barreiroleo/dimmer-rms/readme.md

# Dimmer RMS

**_Se recomienda abrir las imagenes en pestañas nuevas para su mejor visualización._**

## Roadmap

- [x] Acondicionar señal.
- [x] Manejar interrupción.
- [ ] Implementar frecuencimetro.
- [x] Implementar método para obtener tiempo de trigger para objetivo duty.\
       Podría implementarse por busqueda en una tabla o por método numérico.
- [ ] Implementar comunicación I2C con maestro.

## Signal conditioning

Partiendo de una señal alterna dada por una senoidal fundamental y otra senoidal de mayor frecuencia y menor amplitud.

<!-- $$
vsin(t) = 150v \cdot \sin(2\pi \cdot 50Hz  \cdot t)
vnoise(t) = 2v \cdot \sin(2\pi \cdot 10kHz \cdot t)
v(t) = vsin(t) + vnoise(t)
$$ --> 

 
 

Se comparan dos diseños:

- ZCD clásico. Rectificador de onda completa con salida optoacoplada.
- ZCD adaptado. ZCD clásico con amplificador intermedio.

<p align="center">
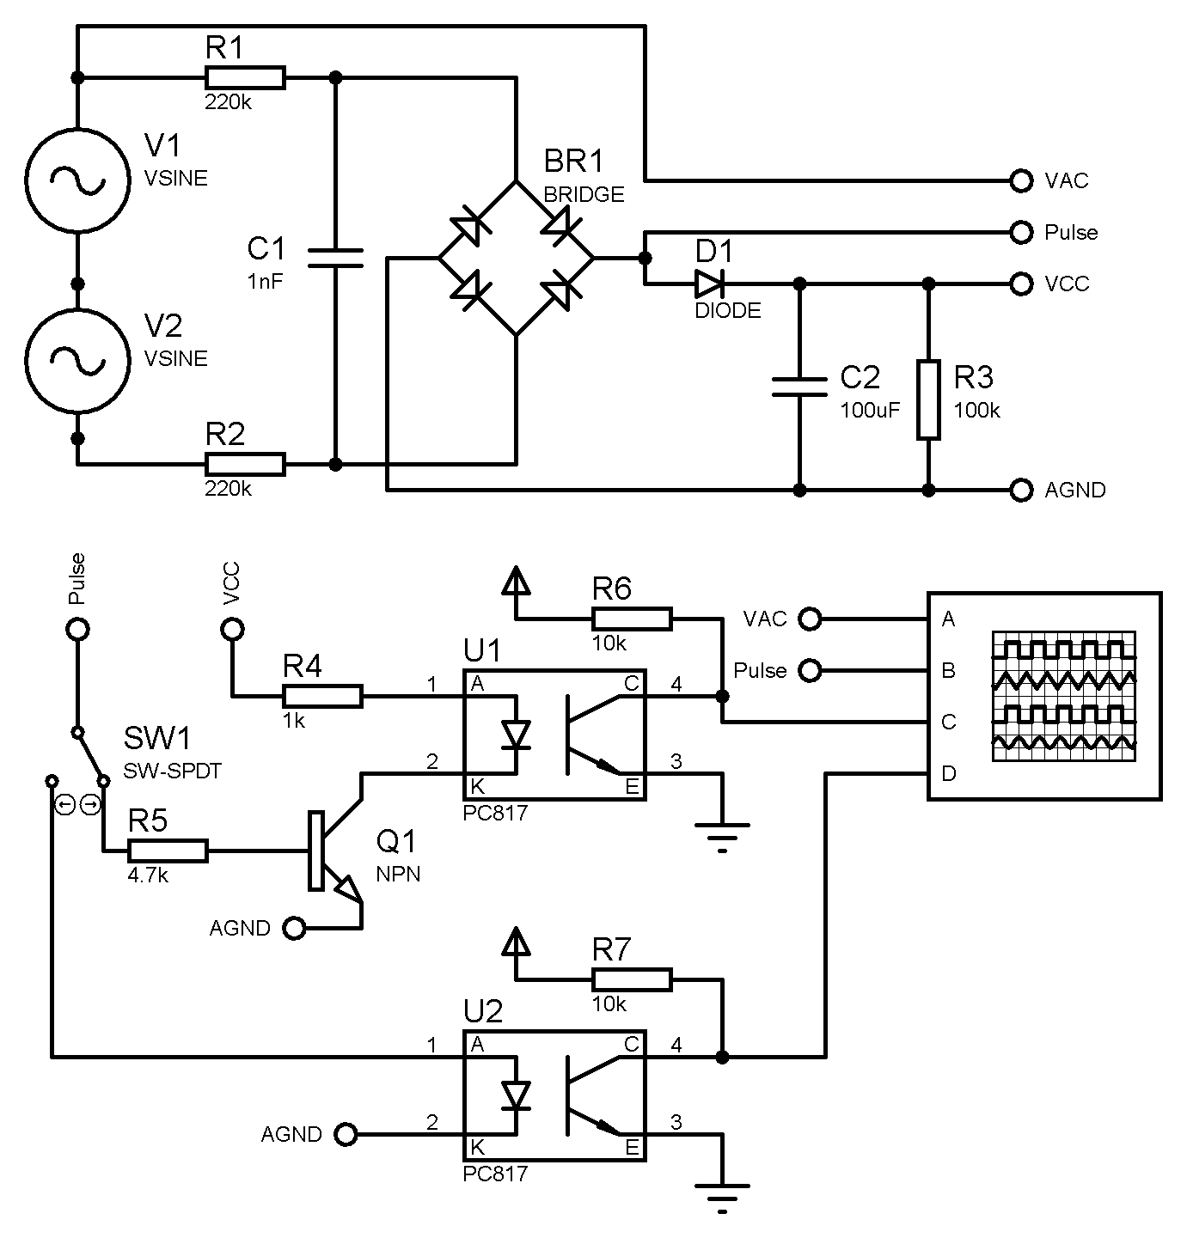
[picture p1: model/ZeroCross/Zero Cross.BMP]

</p>

En el diseño adaptado, se han implementado algunas modificaciones.
- Filtro pasa bajos. Compuesto por R1/C1 y R2/C1 según el semiciclo.
  <!-- $$
  LPF = \frac{1}{(2\pi \cdot 220k\Omega \cdot 1nF)} \approx 720Hz
  $$ --> 
  
- Fuente CC primitiva. Compuesta por D1, C2 y R3. El capacitor de esta fuente debe almacenar la suficiente energía para alimentar al optoacoplador durante la mayor parte del semiperíodo.\
  Las resistencias R1 y R2 deberán tener el valor adecuado para garantizar la recarga de C2 en el tiempo que dure la detección de cruce.
- Amplificador clase E. Permanente en estado alto salvo en los cruces por cruce de cero. En dicho cruce al abrirse Q1, dado el pull up, la salida optoacoplada tiene salida en alto.

Las oscilografías siguientes corresponden al detecctor clásico y al modificado respectivamente.

<p align="center">
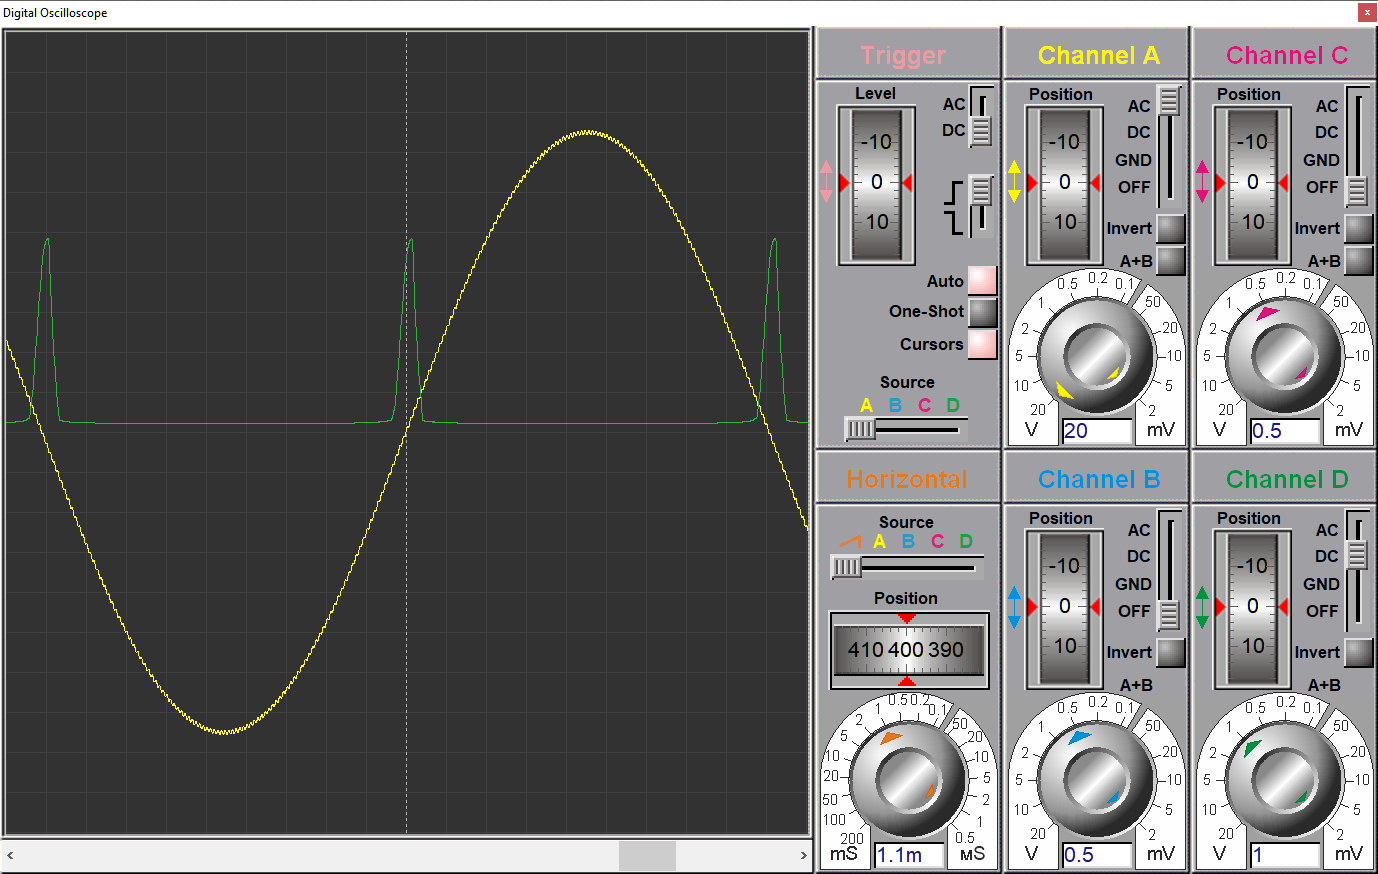
[picture p2: model/ZeroCross/1-ZCD Normal.png]
ZCD Normal.png

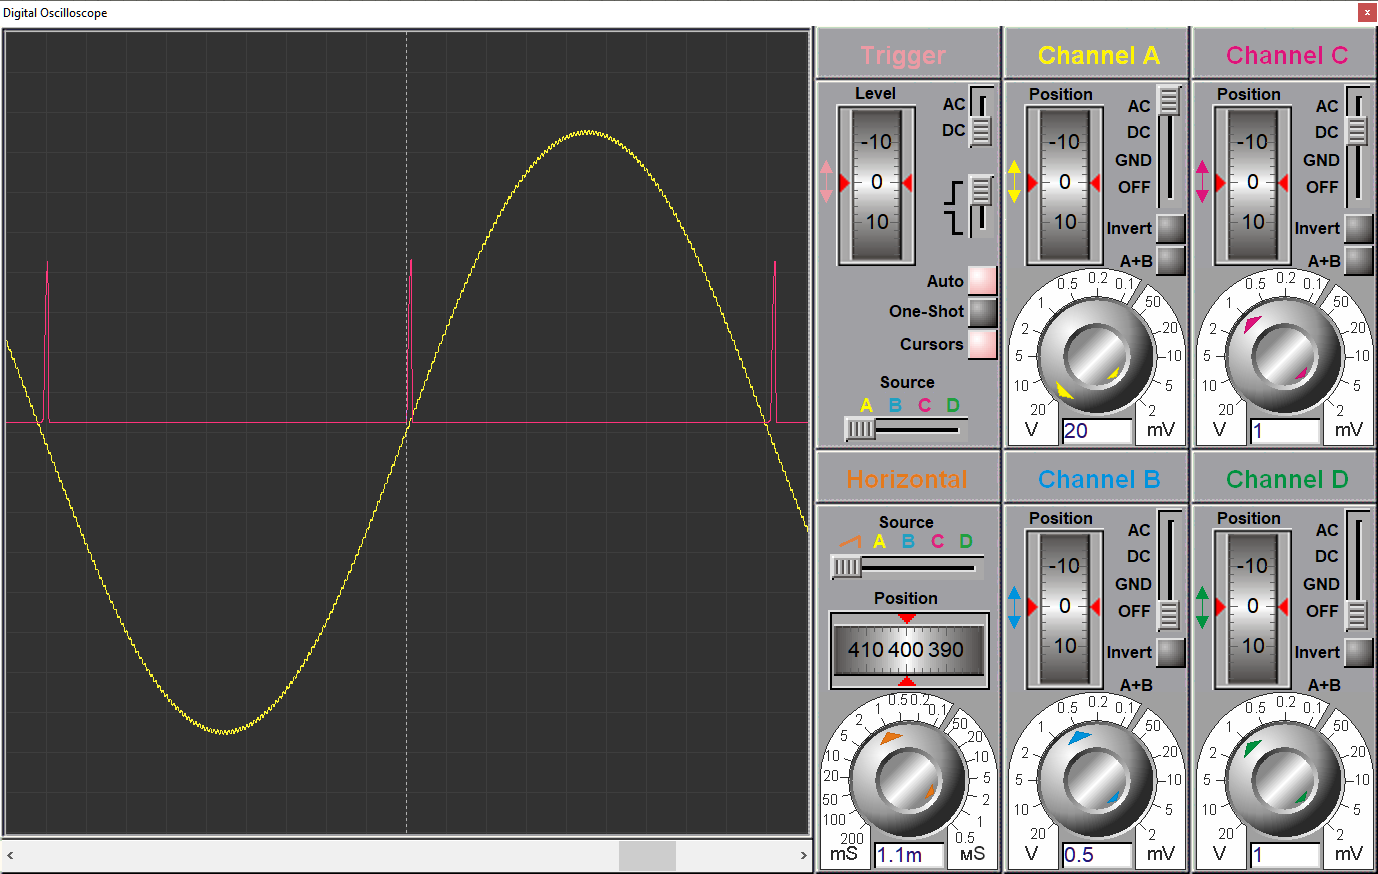
[picture p3: model/ZeroCross/2-ZCD Boost.png]
ZCD Boost

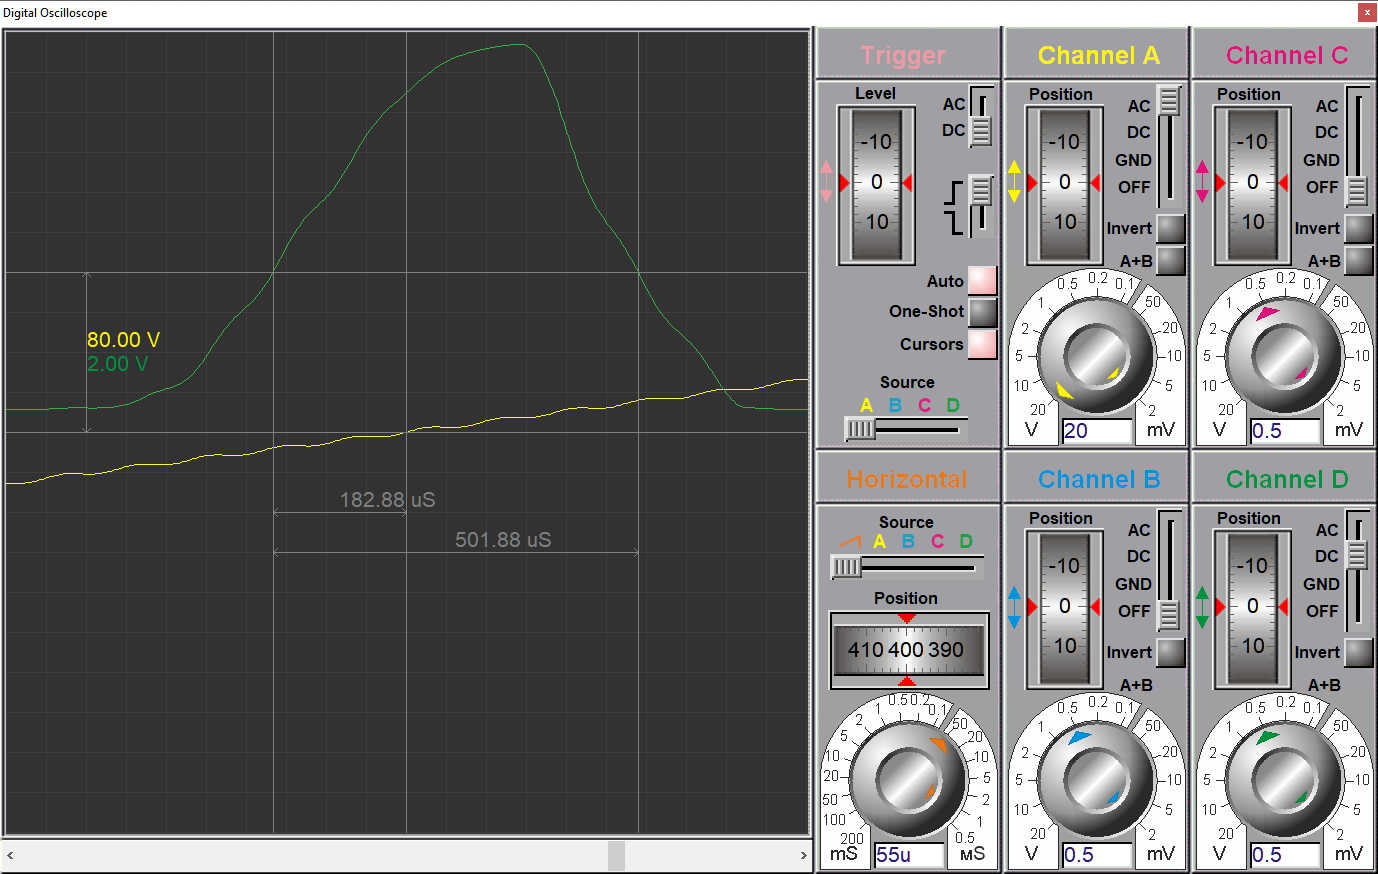
[picture p4: model/ZeroCross/3-ZCD Normal - Detail.png]
ZCD Normal

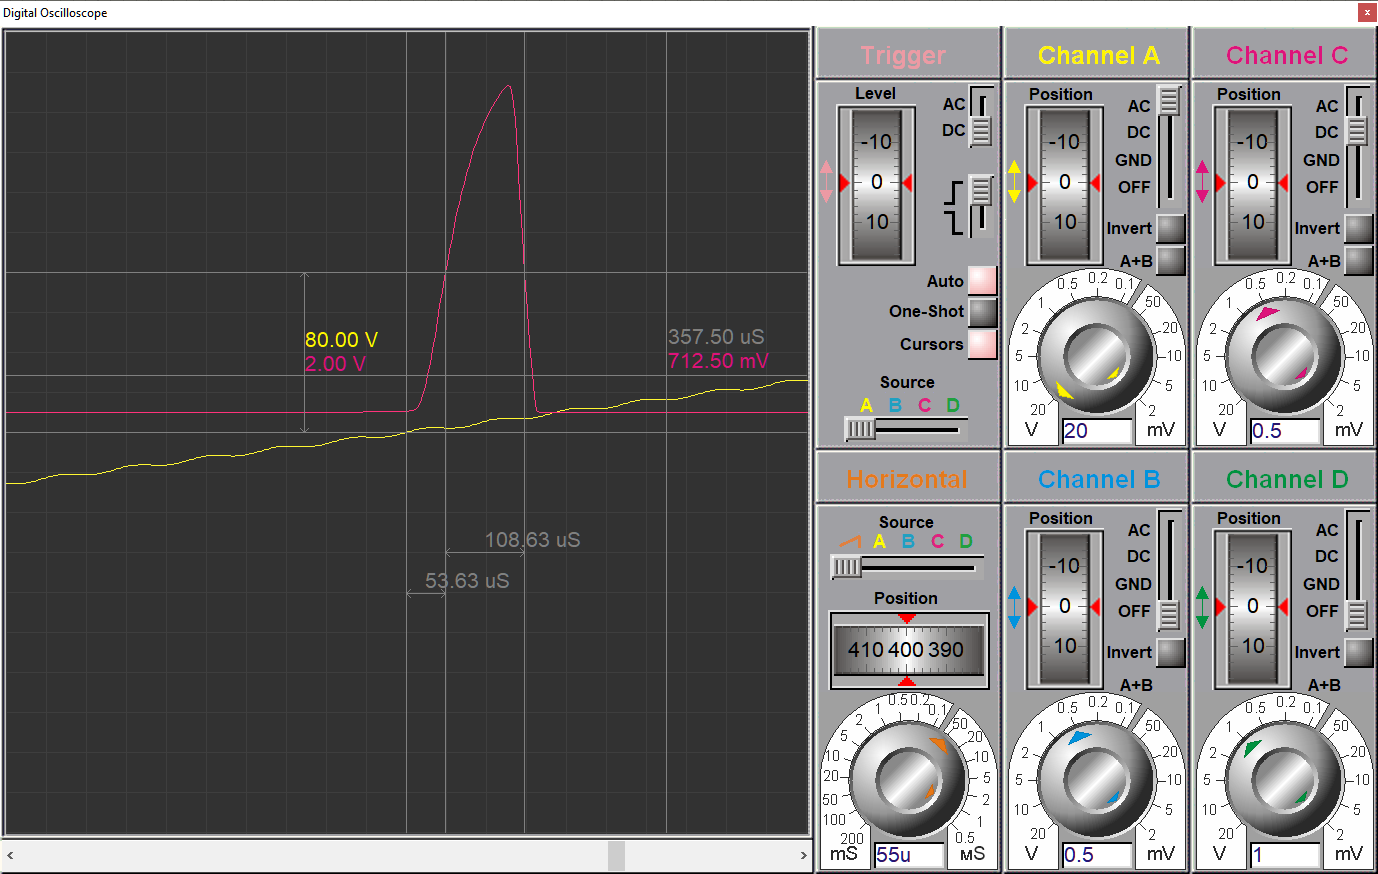
[picture p5: model/ZeroCross/4-ZCD Boost - Detail.png]
ZCD Boost

</p>

- En el detector clásico, el umbral de detección se presenta 180us antes del cruce y perdura hasta casi 320us después del mismo.
- En el detector modificado, el umbral de detección se presenta 53us después del cruce.
- Siendo lo importante el flanco ascendente de detección, se mejora el tiempo de detección en un 70.88%

## RMS Implementation
Para entender la implementación de una salida RMS, hay que comprender que iguales incrementos fraccionarios de tiempo para el disparo del triac no provocan un cambio proporcional en la potencia de salida.
La relación de variación de valor RMS contra tiempo de interrupción presenta la siguiente forma:
<p align="center">
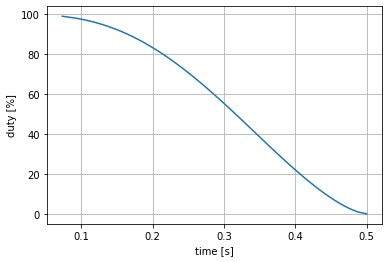
[picture p6: model/Dimmer/Duty vs time.png]
<br>
Modelado con <a href="https://github.com/barreiroleo/dimmer-rms-calc/blob/master/rms_vs_tinterrupt.ipynb">Dimmer RMS Calc</a>
</p>

Con la misma herramienta auxiliar diseñada para obtener el modelo anterior, se obtiene una tabla con puntos de fracción de tiempo que deben aplicarse al semiperiodo de la onda para obtener una fracción RMS específica.

Para esta aplicación la tabla de puntos generada contiene 256 elementos (8 bits).
<p align="center">
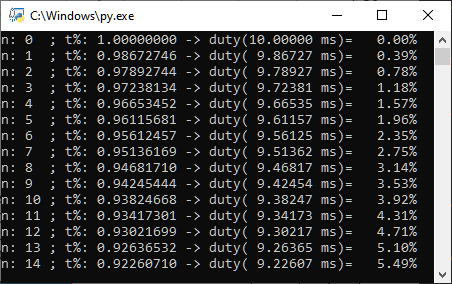
[picture p7: model/Dimmer/Table output.png]
<br>
Archivo <a href="./vector_rms.txt">vector_output.txt</a>
</p>

El producto <!-- $semi\_periode [us] \cdot rms\_time = t [us]$ -->  es el tiempo que se aplica al registro de comparación **OCR1A**. Cuando el **Timer_1** alcance dicha cuenta se procede con el disparo del triac.

Sobre la simulación se implementa un sweep de fracciones RMS, terminado el sweep se leen dos entradas para modificar manualmente el valor de salida. 

Por motivos de rendimiento, se ha reemplazado la etapa de detección por cruce por un generador de pulsos seteado al doble de frecuencia del alternador.

<p align="center">

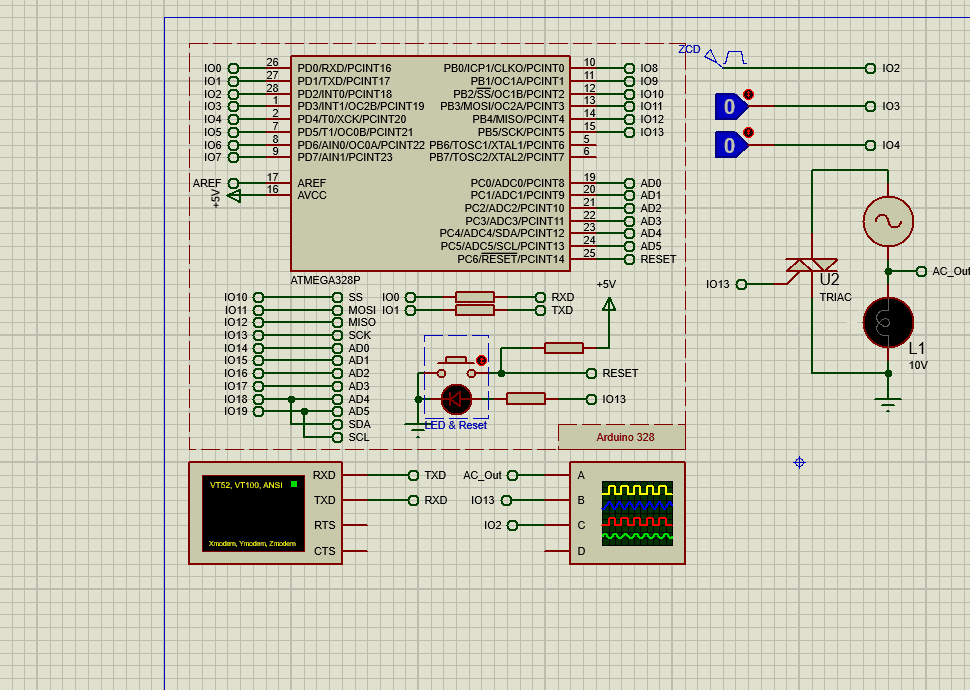
[picture p8: model/Dimmer/Dimmer.gif]
<br>
</p>
