barreiroleo/dimmer-rms/(list of files, drawings)

Other design files:
model/Dimmer/Dimmer.pdsprj
model/ZeroCross/Zero Cross.pdsprj
