barreiroleo/dimmer-rms/model/Dimmer/ZCD issue.png

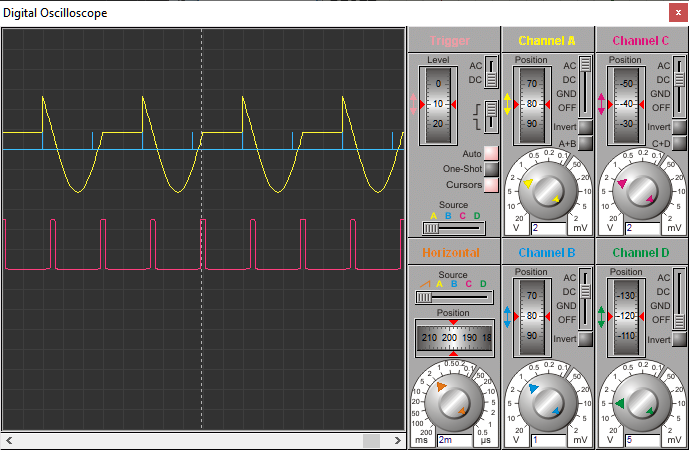
model/Dimmer/ZCD issue.png
