barreiroleo/dimmer-rms/src/Dimmer.h

/**
 * @brief Recibe el valor RMS y devuelve un valor de tiempo de interrupción.
 * El valor RMS tiene resolución de 8 bits (2^8 = 256 valores).
 * El calculo RMS arroja un valor porcentual respecto al maximo valor RMS
 * posible. Es decir que debe mapearse según 0%=0 y 100%=255.
 * Con la herramienta externa dimmer-rms-calc (github.com/barreiroleo/dimmer-rms-calc)
 * se genera el vector con los valores correspondientes a estos puntos.
 * El vector es de tipo {valor; time interrupt %}. Time interrupt % es la
 * fracción del periodo a la que debe aplicarse el disparo para lograr el valor
 * RMS deseado.
 * Notesé que el valor RMS porcentual es independiente del valor de amplitud,
 * por lo cual el tiempo a aplicar solo depende de la frecuencia de la red.
 *
 * Read from PROGMEM:
 * https://esp8266-arduino-spanish.readthedocs.io/es/latest/PROGMEM.html
**/

#ifndef rms_h
#define rms_h

#include <Arduino.h>

const PROGMEM float vector_rms_time[256] = {
    1.00000000, 0.98672746, 0.97892744, 0.97238134, 0.96653452, 0.96115681,
    0.95612457, 0.95136169, 0.94681710, 0.94245444, 0.93824668, 0.93417301,
    0.93021699, 0.92636532, 0.92260710, 0.91893319, 0.91533589, 0.91180858,
    0.90834557, 0.90494186, 0.90159311, 0.89829543, 0.89504539, 0.89183991,
    0.88867622, 0.88555181, 0.88246441, 0.87941194, 0.87639250, 0.87340436,
    0.87044591, 0.86751567, 0.86461227, 0.86173443, 0.85888097, 0.85605079,
    0.85324284, 0.85045616, 0.84768983, 0.84494301, 0.84221489, 0.83950469,
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
};

void rms_time_calc(uint8_t index) {
    uint16_t time_us = semi_periode * pgm_read_float(vector_rms_time + index);
    Serial.print("index: "); Serial.print(index);
    Serial.print("; time us: "); Serial.print(time_us);
    set_timer_1(time_us);
}

#endif
