barreiroleo/dimmer-rms/(commit log)

2021-09-15 feat: zero cross detector
    [Zero Cross.pdsprj]
2021-09-16 feat: modelado capacitor fuente primitiva
2021-09-17 minor updates
    [Zero Cross.pdsprj]
2021-09-17 feat: calculos de timmer
2021-09-17 feat: testing macros for timer
2021-09-17 feat: interrupt implemented
2021-09-18 feat: calculadora auxiliar para obtener tiempos equivalentes en ticks
2021-09-18 feat: timer 1 basic configuration. next to test
2021-09-18 feat: timer implemented. It's working fine!
2021-09-19 feat: triac implemented
    [Dimmer.pdsprj]
2021-09-20 feat: RMS output implemented
    [Dimmer.pdsprj]
2021-09-23 feat: frequencimeter implemented
    [Dimmer.pdsprj]
2021-10-06 fix: Missing fire on triac solved. Parece problema del simulador
    [Dimmer.pdsprj]
